riasatmorshed/name_338_project/Propeller/Propeller Calculation.docx

Propeller Calculation

Total resistance, R=112.6 kN

Effective power, PE = 112.6X10X.5144=579.24 kW

Ship Length, LBP=70.8 m= 232.28 ft

Breadth, B=11.42 m = 37.46 ft

Draft, T=4.4m = 14.44 ft

Speed, V=10 knots

Volume displacement, =2660m³=99652.04 ft³

Propeller diameter, D=.6T=2.6ft

Co-efficient ,DW= D/(√(∇^(1/3)).D) =0.429

LCB=0.34M=1.12ft

Taylor wake fraction,

ω t= 0.22

Dt = (DXB)/(∇^(2/3)) = 0.149

Thrust Deduction factot, t = 0.204

We know,

T(1-t) = R

T = 141.45 kN

ηH = ((1-t))/(1-ω_t) = 1.02

ηR = 1.04

VA = V(1-ωt )=7.8 knot=4.01 ms⁻¹

Shaft immersion, h= D/2+0.2 = 1.5 m

H= T(Draft)- h

= 2.9m

Thrust ,T =141.45 kN

P0 =Patm+ρgH

=129745 N/m²

PV = 1646N/m²

K=0.2(for single screw)

Z=3

D= 3.08m

Here, (A_E)/(A_0)=((1.3+0.3Z)T)/((P_0 -P_v )D^2)+K

= 0.5

We know, KT/j²= T/(ρ.D^2 V_a ^2)

= 1.3

From chart,

nm = .5

j=.4

and P/D=.79

here, j= (V_a)/(nD)

so, n = 3.85 rps = 231.34 rpm

assume, ηD = .7

PD= (P_E)/(η_D) = 579.24/.7 = 827.48 kw

Va = 7.7 knots

Bp = 1.158( (n×P_D ^.5)/(Va^2.5) )

= 45.35

δ = 3.28 (nD)/(Va)

= 252.93

And, P/D = .79

So , From Bp -δ chart we get,

ηo = .52

P/D=.67

Cavitation Check:

p_0 -p_v =99.6-10.05×shaft immersion

p_0 -p_v =99.6-10.05×1.5m

=83.85 kPa

q_(0.7R) =1/2×ρ×V_R ^2

= 1/2×1.000×(V_A ^2 +(0.7×π×n×D)^2

= 1/2×1.000×(4.01^2 +(0.7×π×3.85×2.6)^2

=250.33 kPa

σ_(0.7R) =(p_0 -p_v)/(q_(0.7R)) = 83.85/250.33 =0.33

(A_E)/(A_0)_(necessary) =T/(π/4×D^2 (1.067-0.229P/D)(0.3σ_(0.7R) ^0.5 -0.03)q_(0.7R))

= 141.45/(π/4×2.6^2 (1.067-0.229×0.67)(0.3×0.33^0.5 -0.03)250.33)

Therefore, A_E =0.818 m^2

Assuming A_E =A_D ,

A_E ≈(A_P)/(1.067-0.229×P/D)

A_P =3.97 m^2

τ_c =(T/(A_P))/(q_(0.7R)) =0.14

From Burrill Cavitation Diagram ( τ_c vs σ_(0.7R) ), the value obtained is just below the upper limit for merchant ship propeller.

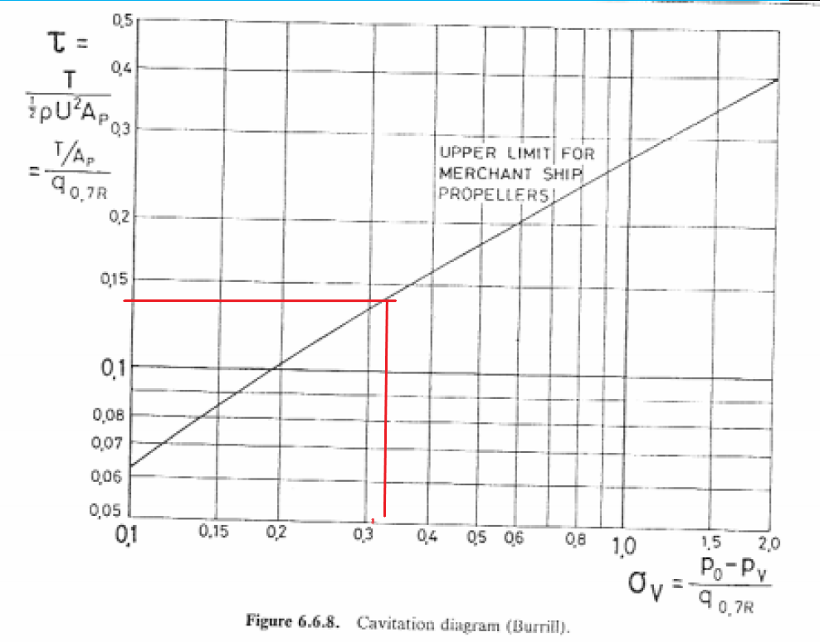
[picture p29: figure]

Here,

ηD Calculated = ηH x ηR x ηo

= 0.55

€ = ηDCalculated – ηD assumed

= 0.55 – 0.7 < 0.005

So, ηD = 0.55
