riasatmorshed/name_338_project/Rudder/Rudder Calculation.docx

Rudder Calculation:

LBP = 70.8 m

LWL = 73.75

T/L = .0621 m

T =4.4 m

L/B = 6.2

B = 11.4 m

Rudder Area:
A=c_1 ×c_2 ×c_3 ×c_4 ×(1.75×L_(WL) ×T)/100 A=1×1×1×1.5×(1.75×73.75×4.4)/100

=3.14 m^2

Yield Strength of mild steel = 235 N/m²

K_r =(235/250)^.75

Aspect ratio= (b^2)/a=b/c=(height)/(breadth)

⇒1.5= (b^2)/A

b^2 =4.71

b=2.17

Since b/T=2.17/2.5=.86 = 86% of the draft but the mean height should be as much as 60%-70% of the draft

Again, Aspect Ratio= 1.3

=(b^2)/A

⇒b^2 =1.3×3.14

⟹b=2.02

Now, b/T=2.02/2.5=.80 = 80% of the draft

Now, considering aspect ratio as 1.2,

(b^2)/A=1.2

b=1.94

c= 1.94/1.2=1.616

Rudder Force and Torque:

Rudder force, C_R =132×A^2 ×V^2 ×k_1 ×k_2 ×k_3 ×k_t

k1= (Aspect Ratio+2)/3=1.067

k2= 1.1(ahead condition)

k3= 0.8

kt=1
CR =132×3.14×12^2 ×1.067×1.1×.8×1

CR =56041.94 kN

Rudder Torque, QR=CR x r

Again, r= c×(α×K_b )

α= .33=for ahead condition

Now, K_b =(A_f)/A=.02

r = 1.616 x (.33 x .2)

= .11 m

QR= 56041.94 x .11

=6164.61 Nm

Rudder Stock:

Dt = 4.2 ×³√(Q_R ×K_R)

= 4.2 ×³√(28600×1)

= 128.4 mm

Couplings:

Db= .62×√((D^3 ×K_b)/(K_r ×n×e))

Kr= 0.95

n= total no of bolts

kb= metal factor for flanges

e= mean distance of of the bolt axis from the center of the bolt system

= 105/100×80

=84

Db= .62×√((80^3 ×1)/(.95×6×84))

= 20.27 mm

=21 mm

Thickness of the coupling flanges:

tr= 0.9 x db

= 0.9 x 21

= 18.9 mm

Thickness of coupling flange clear of the bolt hole,

Ts= (.65 x 21)mm

= 13.65 mm

Rudder Plating:

tp= 1.74 ×a×√(P_r ×k)+2.9

a= unsupported width

= 0.34 m

Design Pressure, Pr= 10T+ (C_R)/(10^3 ×A)

= 102.51+ 56.041/(10^3 ×3.44)

=25.11 kN/mm²

Thickness of rudder plating, tp= 1.74×.340×√(25.11×1)+2.5

= 5.46 mm

=6 mm

Thickness of the web is not to be less than, tw= .7 x 6mm= 4.2 mm

Rudder Bearings:

Tmin= 8 mm(since metallic material would be used)

Projected Surface, Ab= (B_i)/q

Bi= 56041.94 N = support reaction at carrier bearing

q= 7 N/mm²

Again, Abn= bearing height x external diameter of liner

External diameter of the liner= (Dt x tmin x 2)

= (80 + 18.9 x 2)

= 117. 8 mm

The diameter of the pintle, dp= 0.35 ×√(B_i ×K_r)

Bi= 56041.94= support reaction at the pintle

dp=80.75 mm

=81 m
