riasatmorshed/name_338_project/Scantling/Scantling Calculation.docx

Particulars:

Length: 70.8 m

Breadth: 11.4 m

Depth: 5.7 m

Draft: 4.4 m

Deadweight-Displacement Co-efficient: 0.7

Deadweight: 2000 tons

Displacement: 2660 tons

Material Factor, k: taking steel yield stress as 235MPa

k = 1

Web Frame Spacing: 1.8 m

Frame Spacing: 0.6 m = 600mm¹ Ship Construction by DJ Eyer

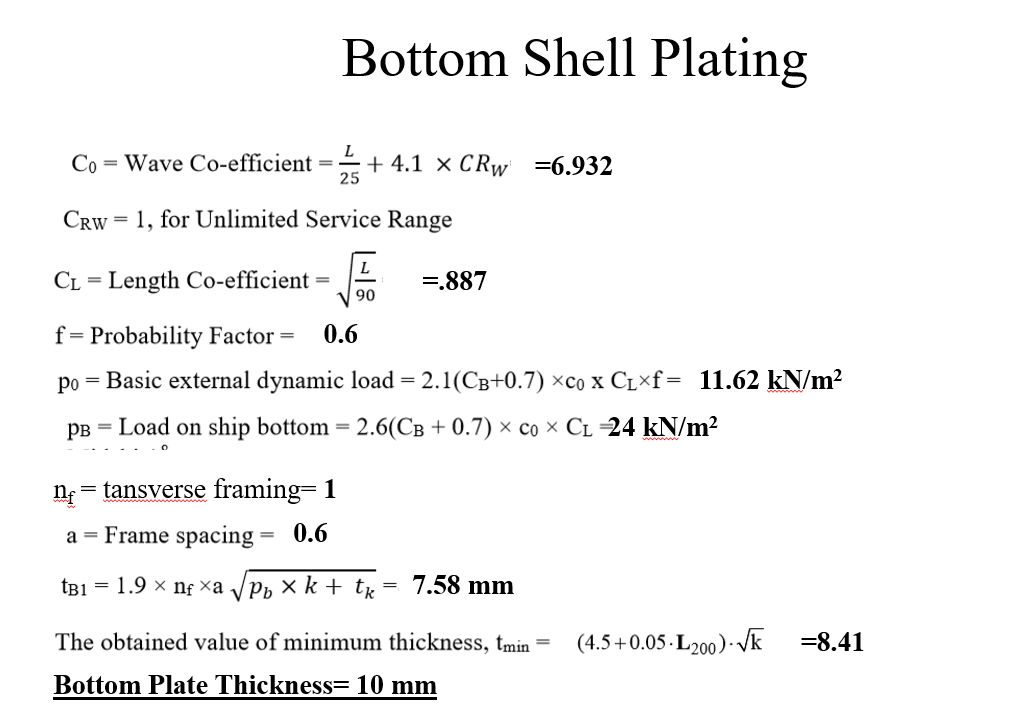
[picture p30: figure]
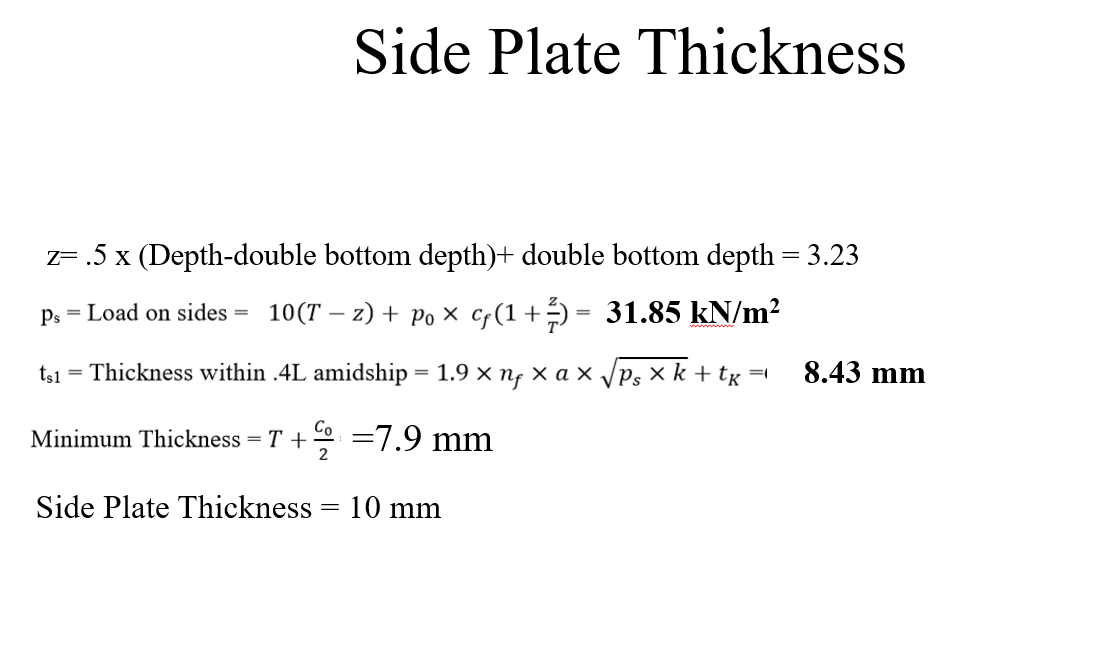
[picture p31: figure]
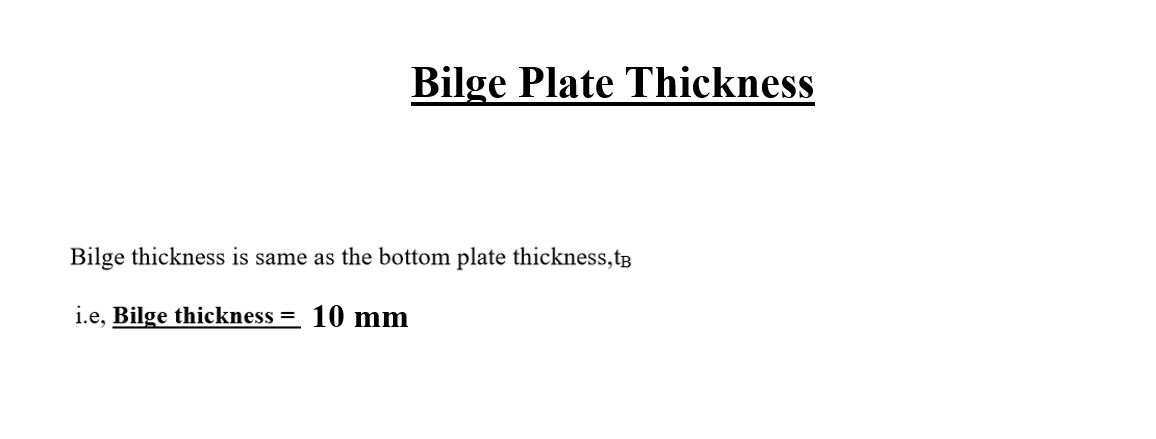
[picture p32: figure]
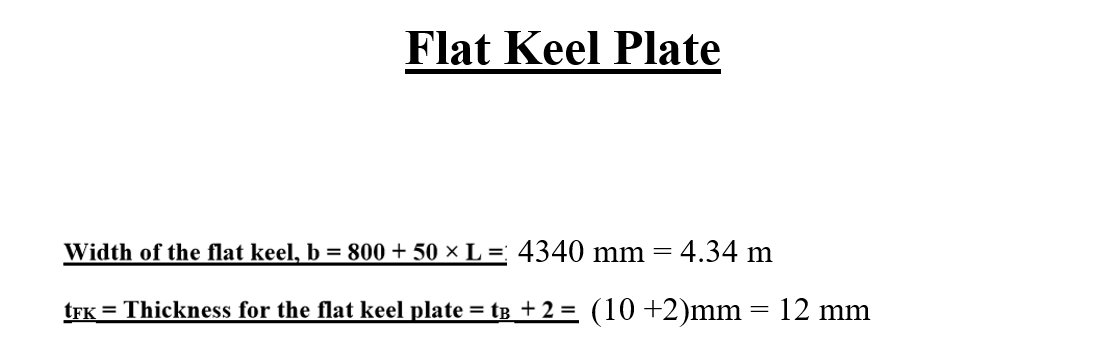
[picture p33: figure]
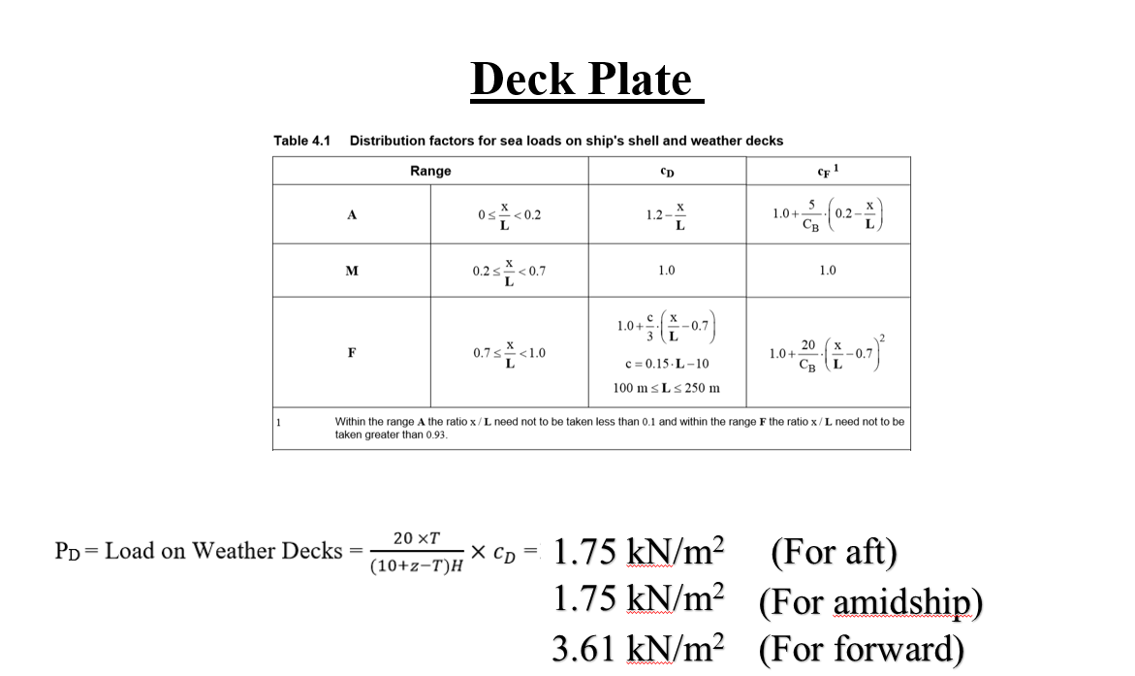
[picture p34: figure]
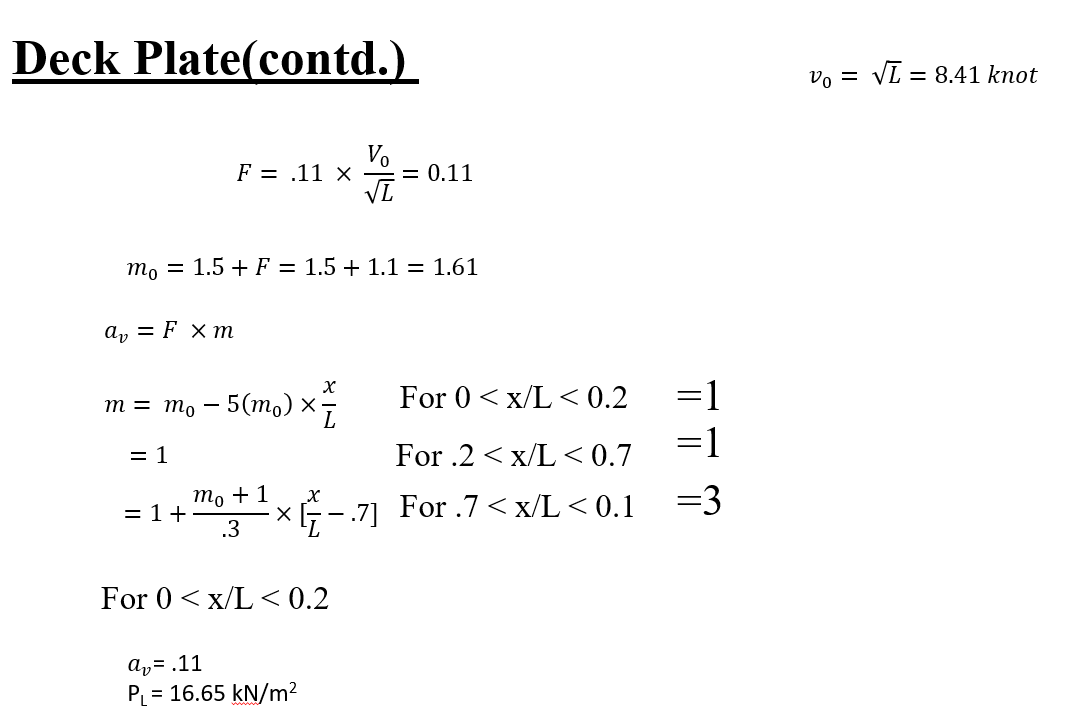
[picture p35: figure]
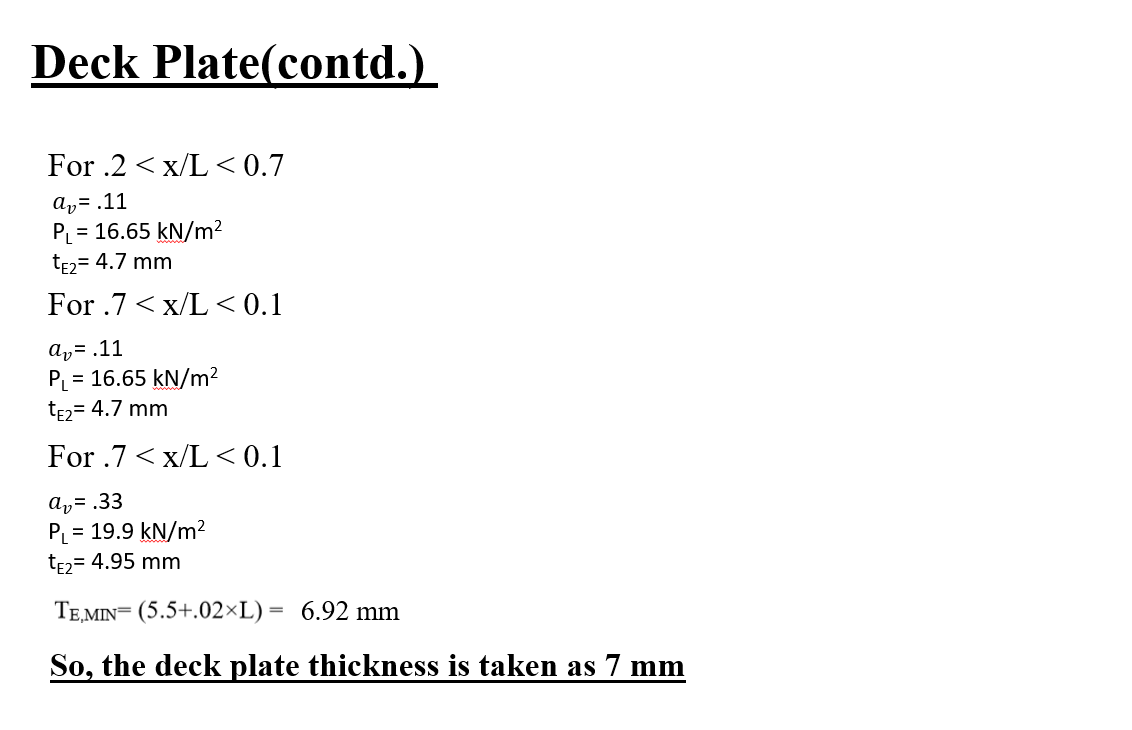
[picture p36: figure]
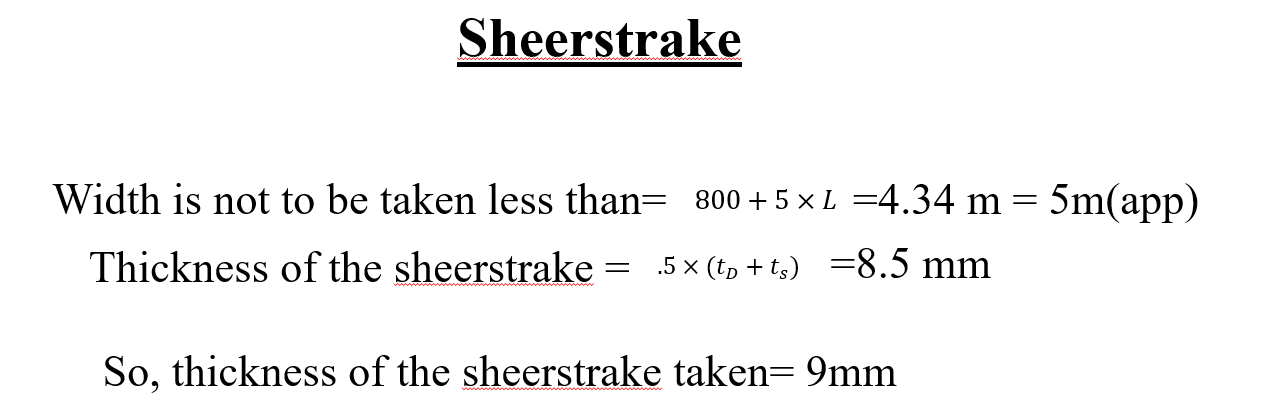
[picture p37: figure]
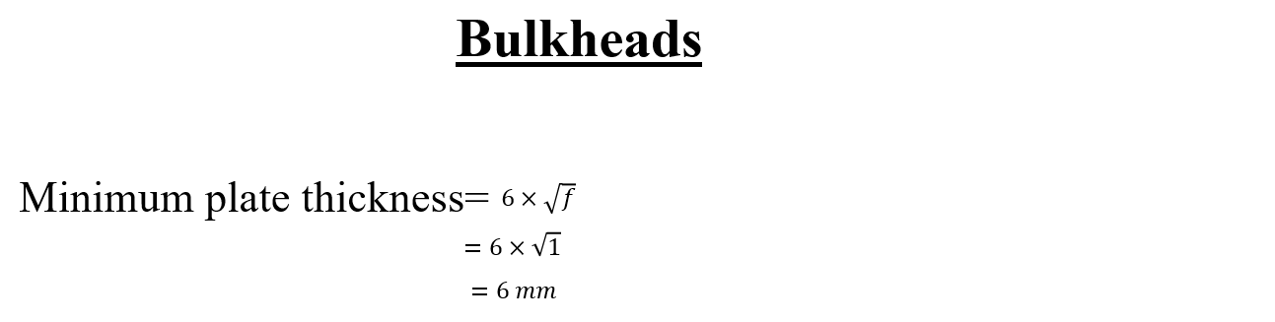
[picture p38: figure]
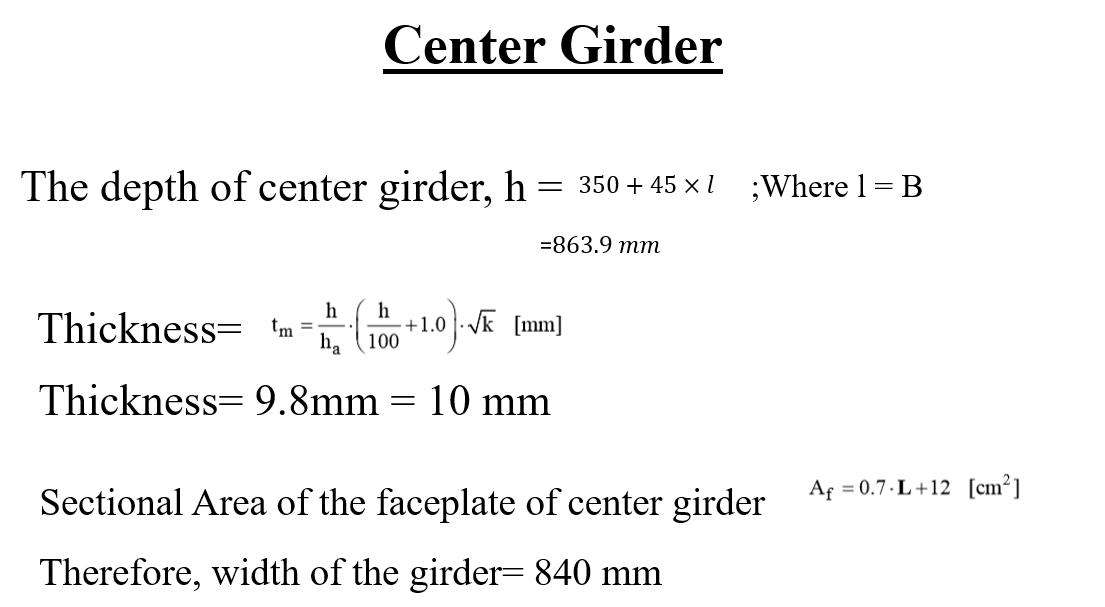
[picture p39: figure]
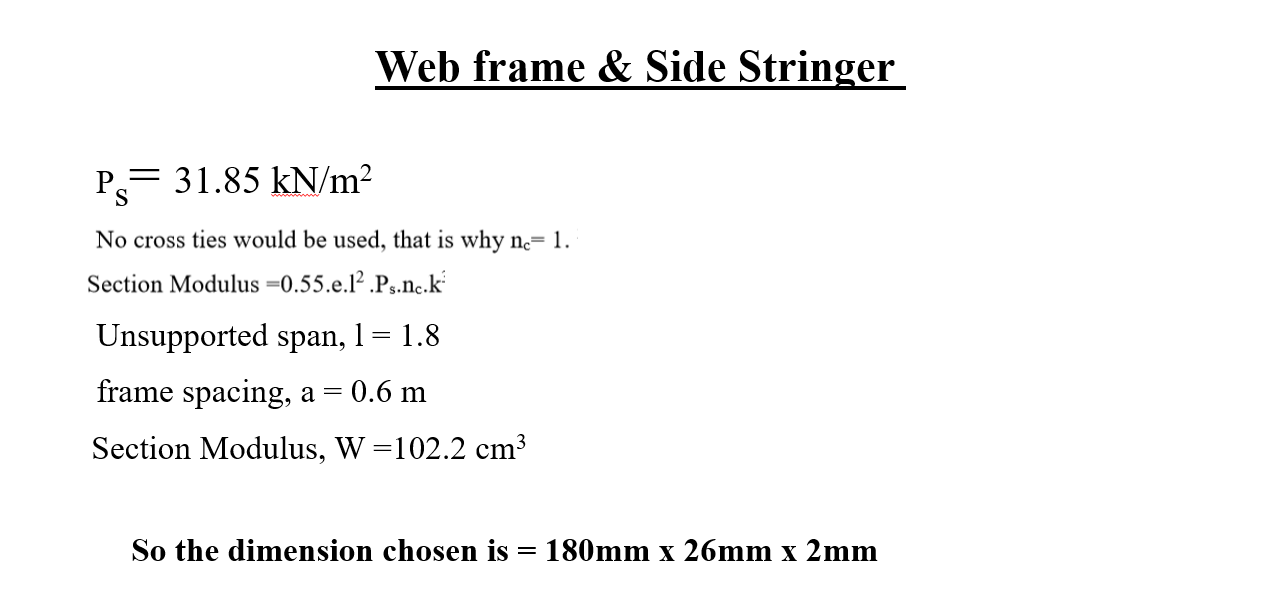
[picture p40: figure]
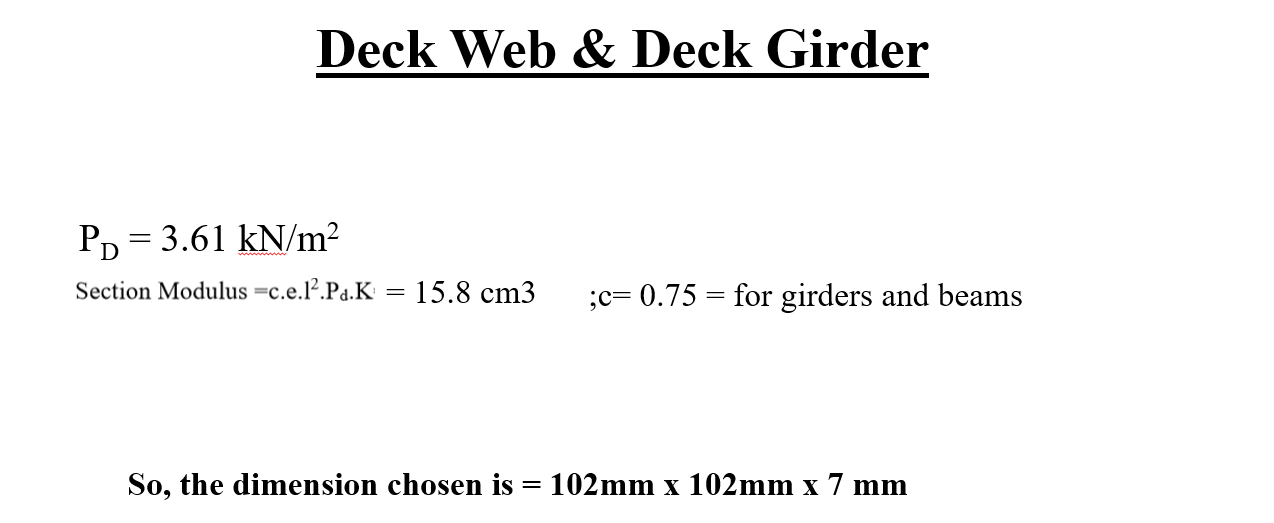
[picture p41: figure]
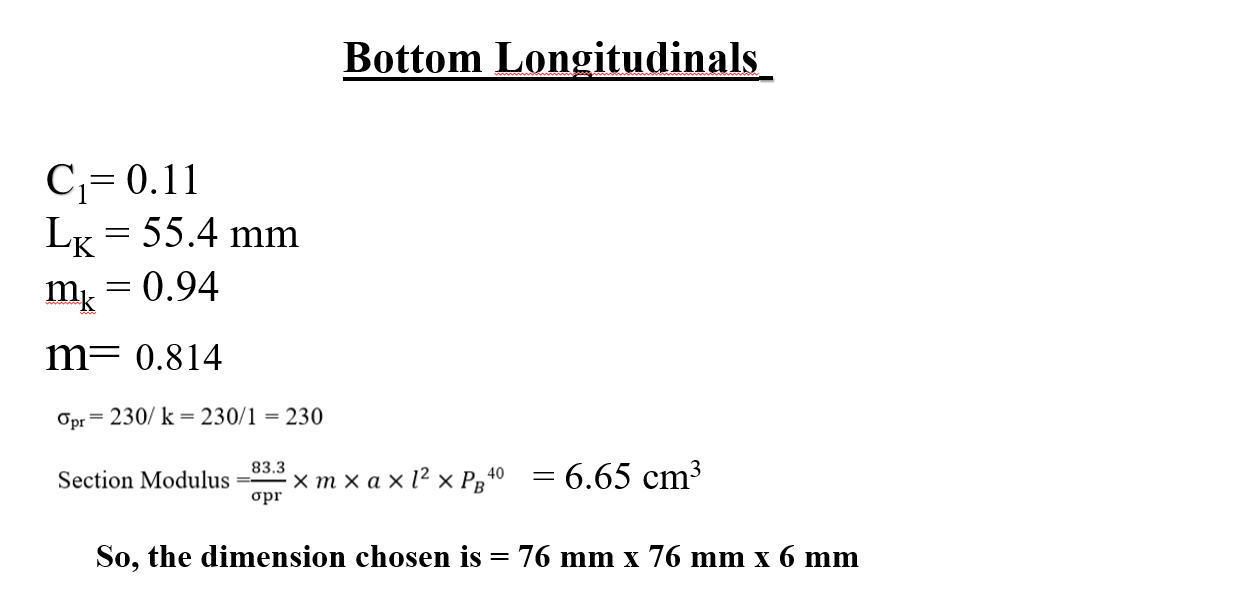
[picture p42: figure]
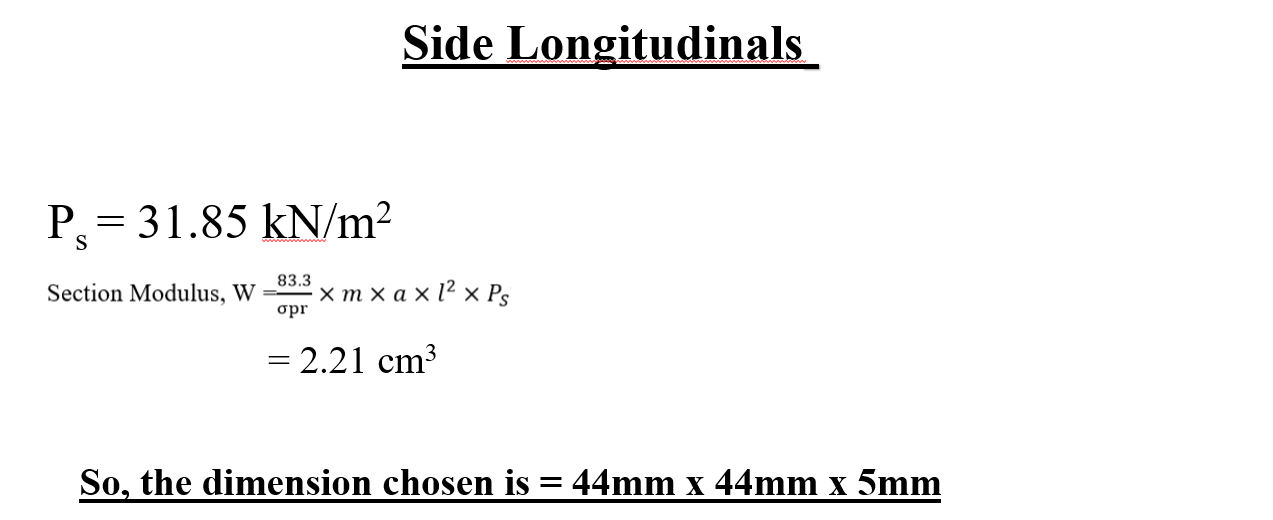
[picture p43: figure]
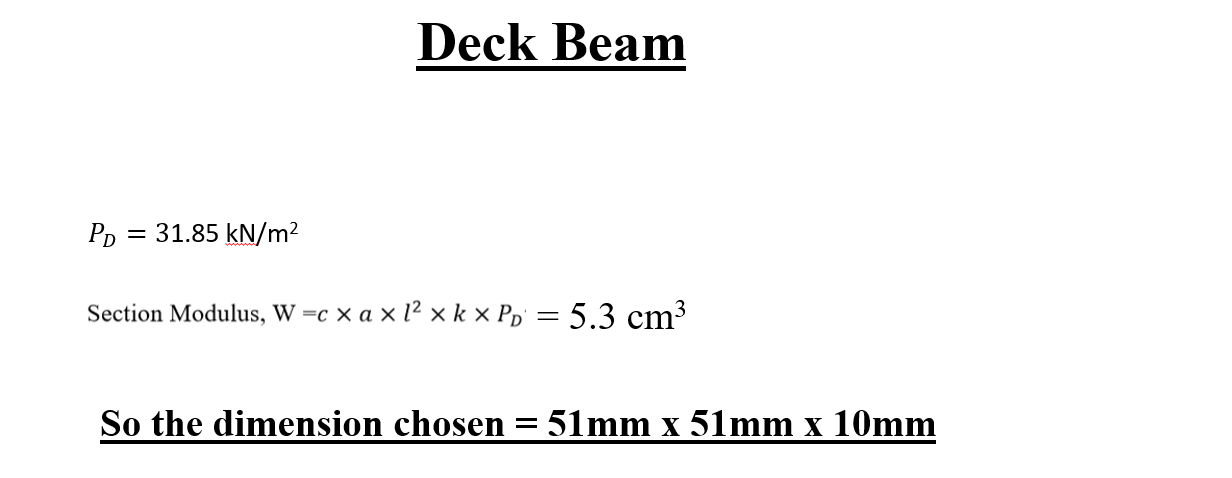
[picture p44: figure]
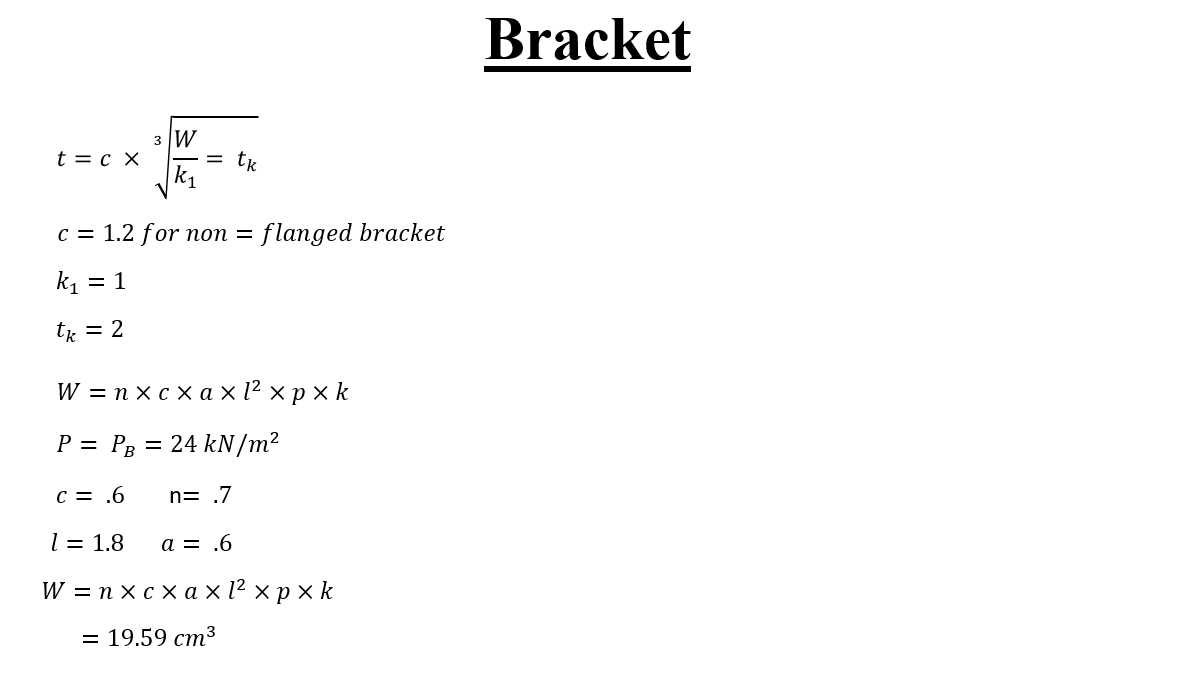
[picture p45: figure]
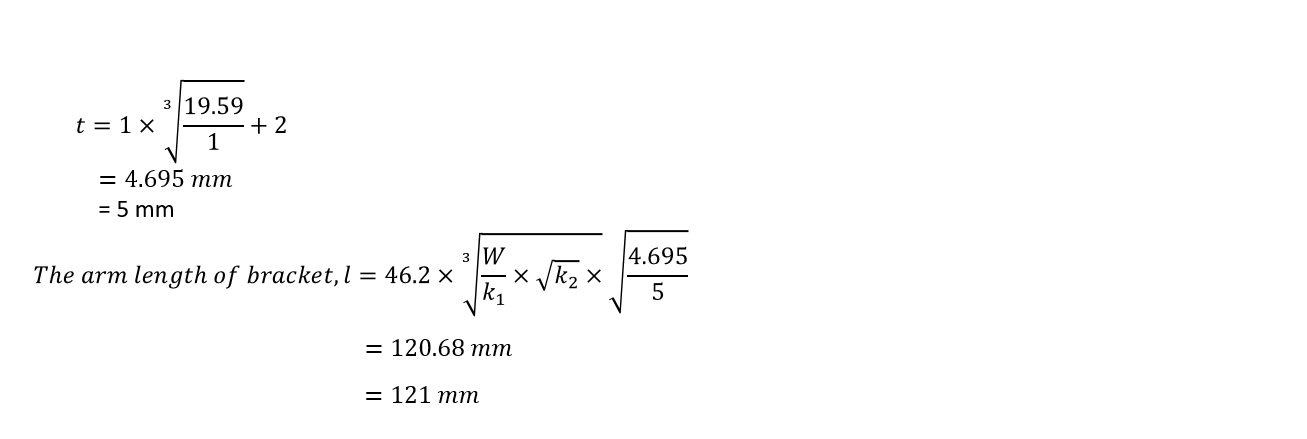
[picture p46: figure]
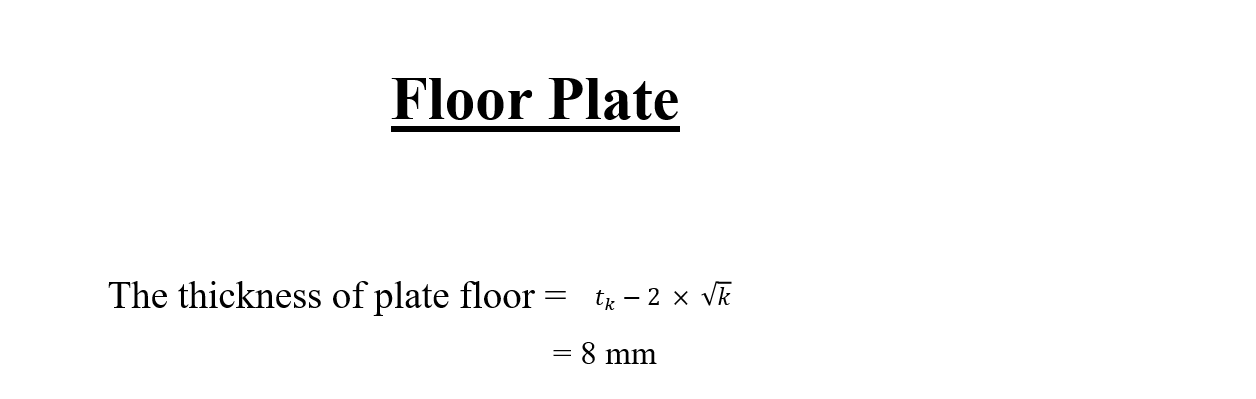
[picture p47: figure]
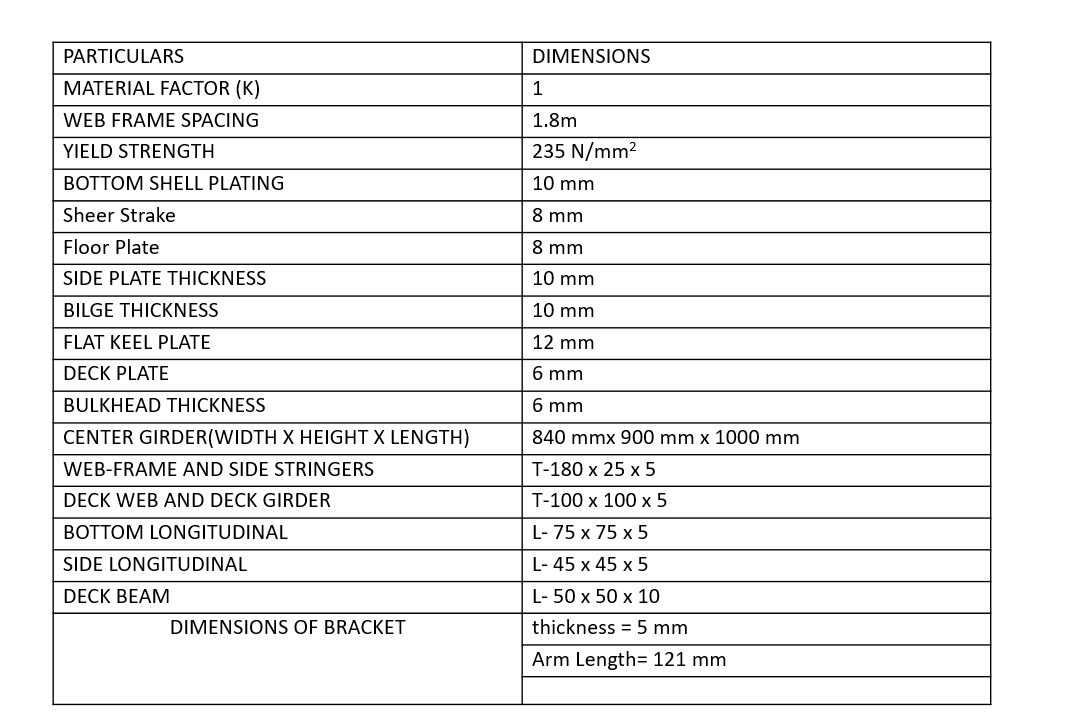
[picture p48: figure]
