riasatmorshed/name_338_project/Steering Gear/Steering Gear Arrangement Calculation.docx

Steering Gear

Principle Particulars:

LBP = 70.8 m

LWL = (1+.0167) x 70.8 = 72m

B = 11.4 m

T = 4.4 m

Particulars of Rudder:

b= height= 3.2

c= breadth =2.27

Rudder Area, A = 8.52 m²

Aspect Ratio = 1.2

Rudder Stock:

Dt = 4.2 x ³√(Q_R ×K_r)

= 4.2 x ³√(11615.912×1)

= 100 mm

Force and Torque Calculation:

Rudder Force, C_R =132 ×A^1 ×V^2 ×k_1 ×k_2 ×k_3 ×k_t

= v = v0 for ahead condition

k1= (Aspect ratio+2)/3 = 1.067

k2 = 1.1 (ahead condition)

k3= .8 (rudder outside the propeller jet)

kt= 1(normally)

CR = 132 x 8.52 x 10² x 1.067 x 1.1 x .8 x 1

= 105599.2 N

Rudder Torque, QR= CR x r

Again, r = c ( α ×K_b ) α=.33= for ahead condition

Kb = (A_f)/A = .2

r = 2.27x (.33 x 0.2)

= 0.15 m

QR = 105599.2 x .11

= 11615.912 Nm

This value is for ahead condition.

Now, for astern condition,

Taking 40% of 10 knot yields 4 knot which is below 5 knot. So as per instruction 6 knot is taken for calculating astern condition.

C_R =132 ×A^2 ×V^2 ×k_1 ×k_2 ×k_3 ×k_t

= 132 x 8.52 x 6² x 1.067 x 1.4 x .8 x 1

= 48383.63

Rudder Torque, QR= CR x r

Again, r = c (α × Kb)

α = .33 = for ahead condition

Kb = Af /A= 0.2

r = 2.27 x (.33 x 0.2)

= 0.15 m

QR = 105599.2 x .11

= 11615.912 Nm

Which is still greater than astern condition. Therefore, value for ahead condition is taken and previous calculation is taken as final result. And previous calculation is given below:

C_R =132 ×A^2 ×V^2 ×k_1 ×k_2 ×k_3 ×k_t

= v = v0 for astern condition

CR = 132 x 3.14 x 7² x 1.067 x 1.4 x .8 x 1

Here, other than k2 all the coefficients are as same as the ahead condition.

Therefore, CR= 24300 N

Rudder Torque, QR= CR x r

Again, r = c (α × Kb)

α = .33 = for ahead condition

Kb = Af /A= 0.2

r = 2.27 x (.33 x 0.2)

= 0.15 m

QR = 105599.2 x .11

= 11615.912 Nm

=12 kN

Steering Gear Arrangement Selection:

From 12 kN-m torque result we end up with Hydroster’s MS Series Piston type hydraulic steering gear arrangement .

And the design-model is “MS-25-35”

This particular model is capable of delivering 12 kN of working torque at working pressure wth α = 35°

And design torque is 25 kN with the angle, α = 35°
