riasatmorshed/name_338_project/Scantling/Scantling Calculation_pdf_format.pdf

Particulars:

Length: 70.8 m

Breadth: 11.4 m

Depth: 5.7 m

Draft: 4.4 m

Deadweight-Displacement Co-efficient: 0.7

Deadweight: 2000 tons

Displacement: 2660 tons

Material Factor, k: taking steel yield stress as 235MPa

k = 1

Web Frame Spacing: 1.8 m

Frame Spacing: 0.6 m = 600mm¹

Ship Construction by DJ Eyer


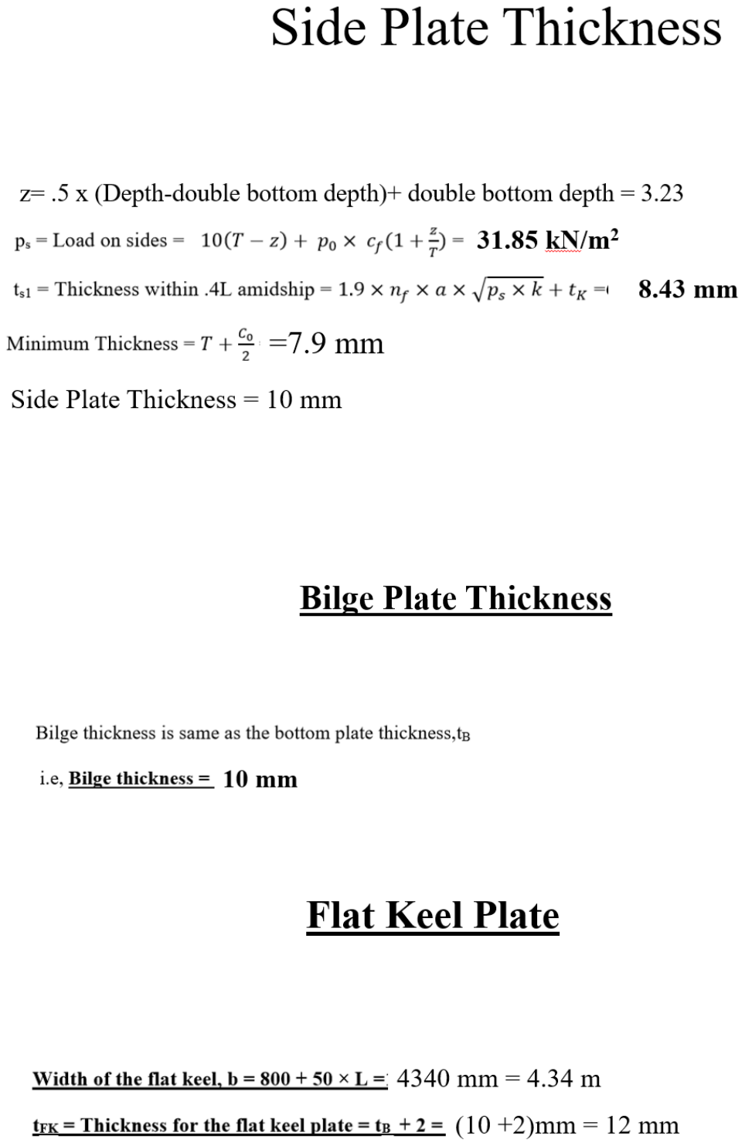
[picture p49: figure]

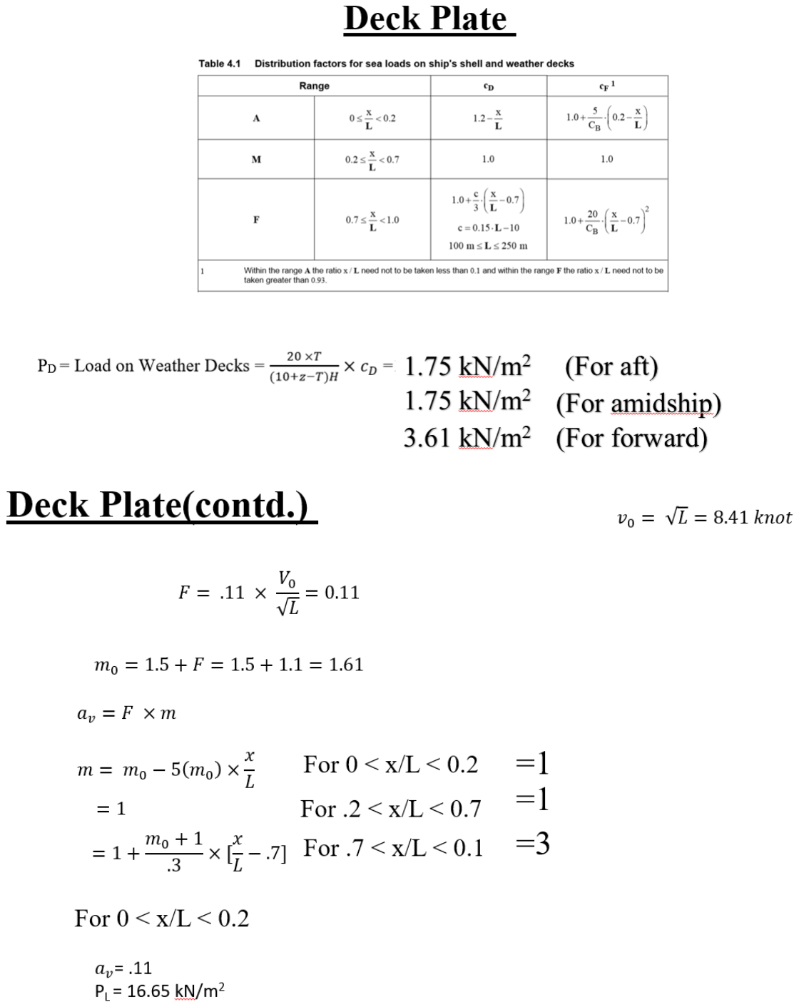
[picture p50: figure]
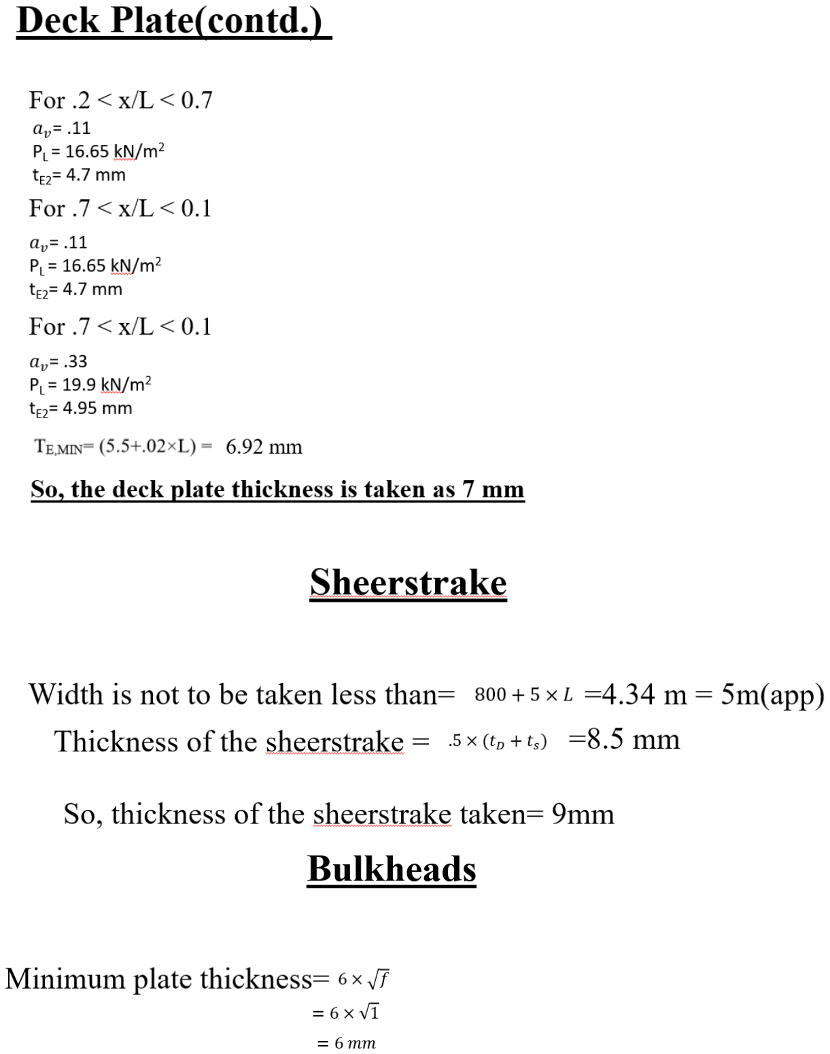
[picture p51: page 4]
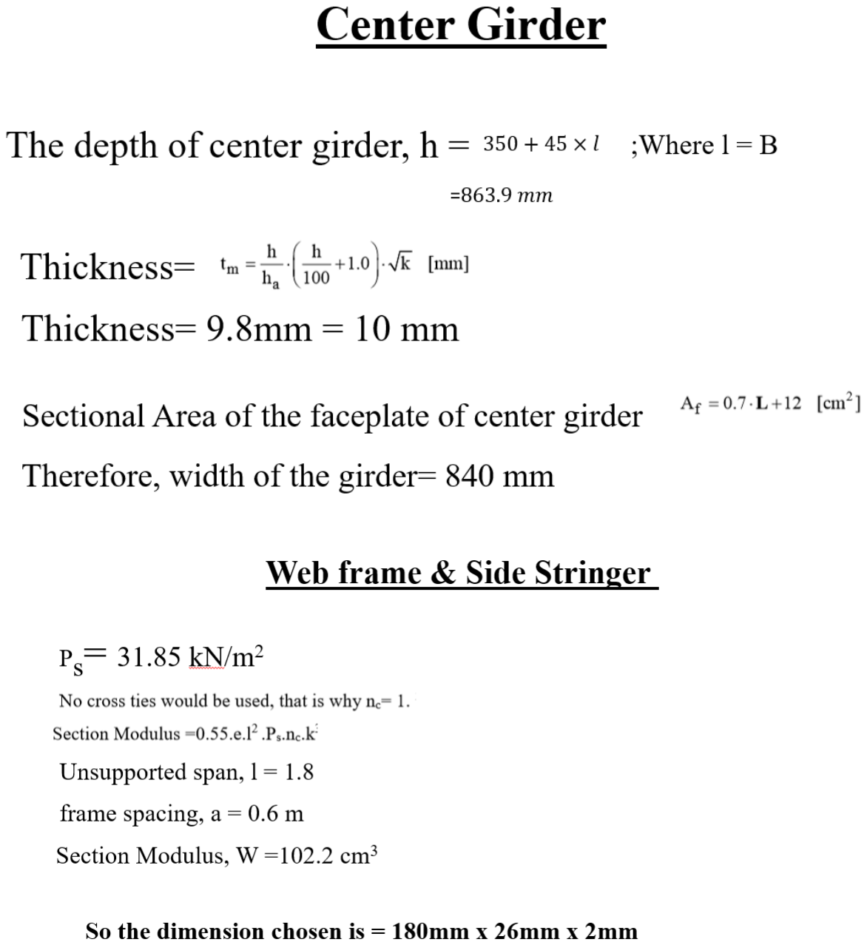
[picture p52: page 5]
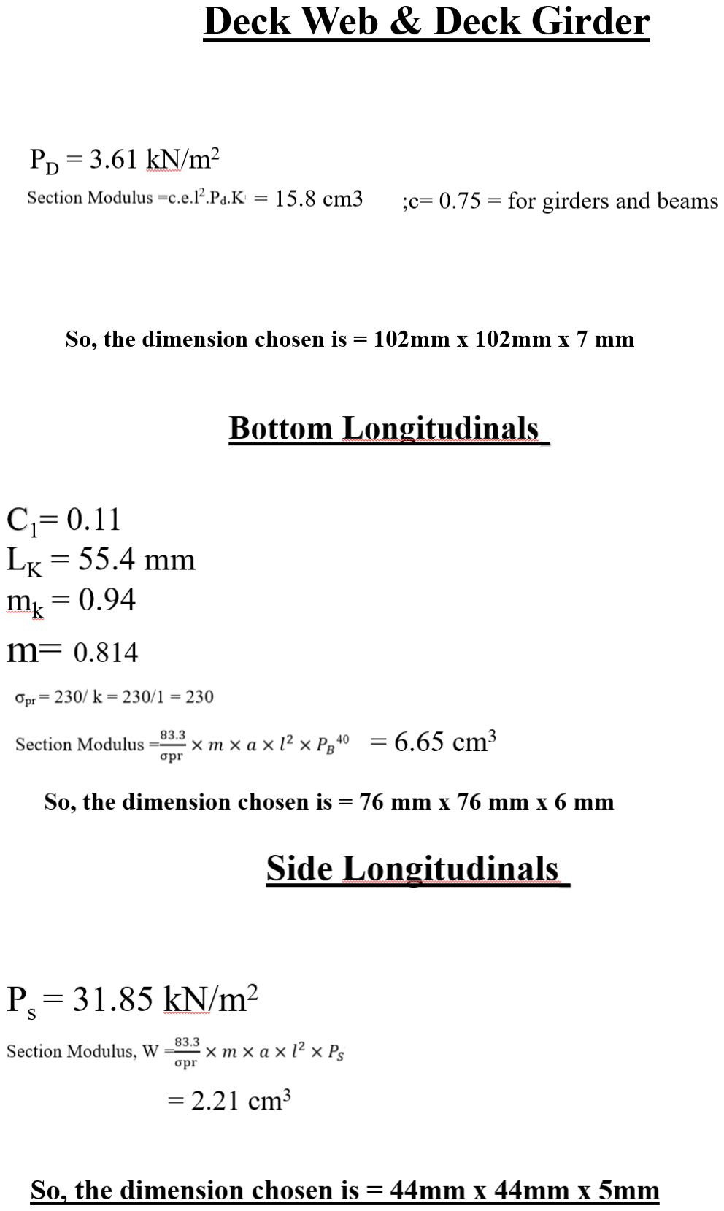
[picture p53: page 6]
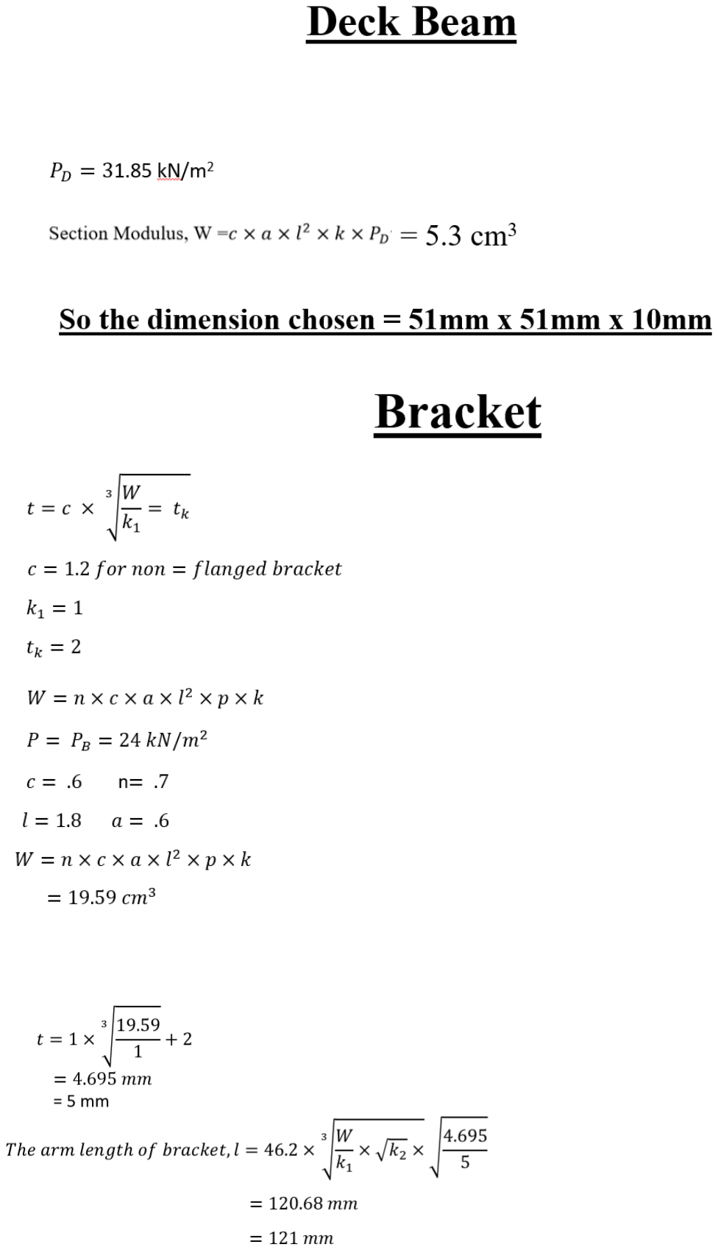
[picture p54: page 7]
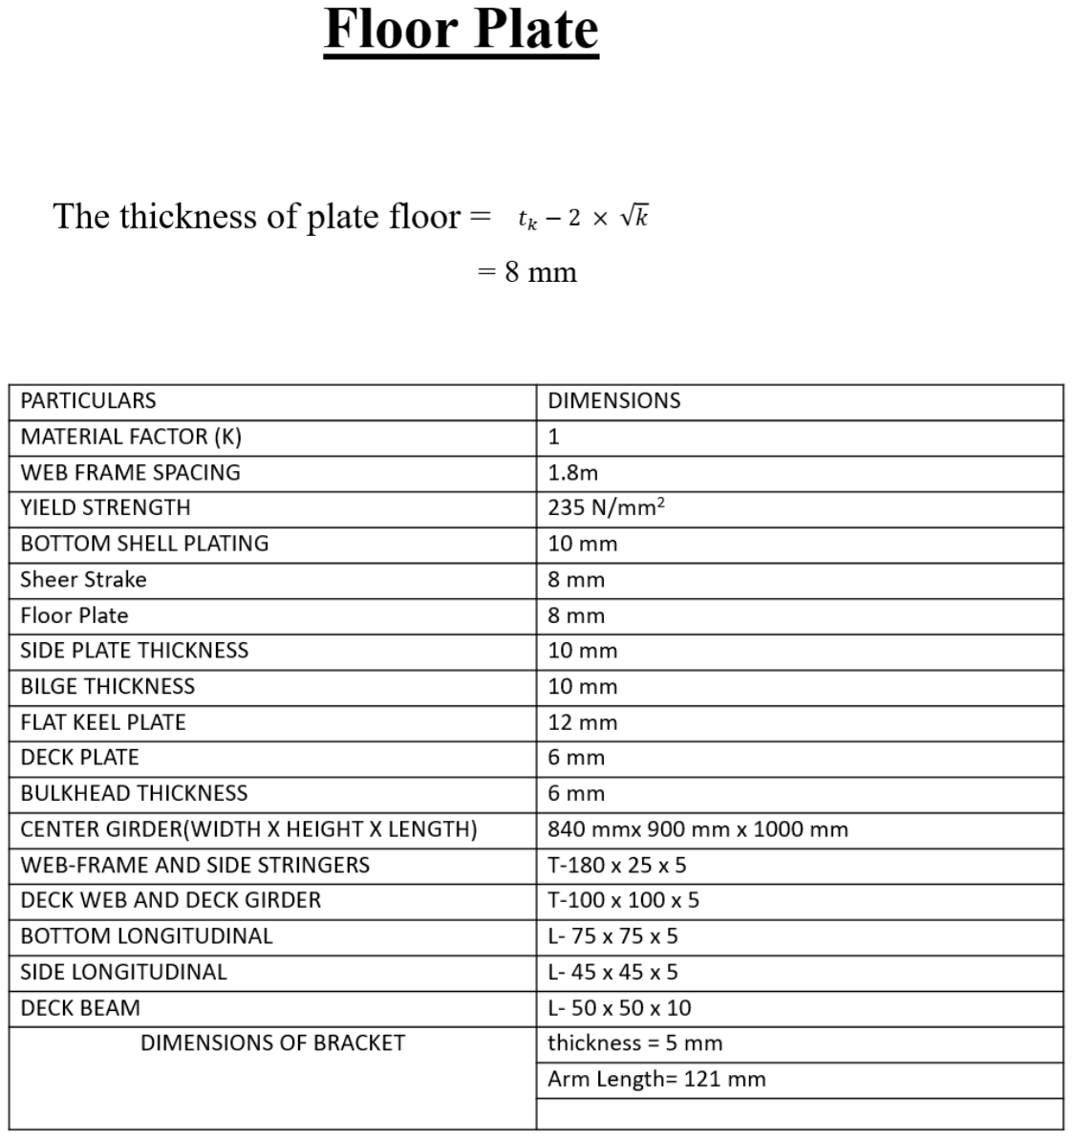
[picture p55: page 8]
