riasatmorshed/name_338_project/Weight Calculation/Weight_Calculation_Final.xlsx

Sheet: Combined LCG-VCG
 |  | Lightweight Calculation
 |  | Item | Weight (tonne) | LCG from Midship (m) | Moment for LCG (t-m) | VCG from keel (m) | Moment for VCG (t-m)
 |  | Center Girder | 8.43 | 0.24 | 2.0232 | 0.4 | 3.372
 |  | Side Girder |  |  | 0
 |  | 1 | 7.29 | 0.46 | 3.3534 | 0.68 | 4.9572
 |  | 2 | 7.29 | 0.46 | 3.3534 | 0.68 | 4.9572 | LCG= | 0.2485841364
 |  | 1 | 6.2 | 0 | 0 | 0.46 | 2.852 | VCG= | 0.5788880652
 |  | 2 | 6.2 | 0 | 0 | 0.46 | 2.852
 |  | sum | 26.98 | 0.92 | 6.7068 | 2.28 | 15.6184
 |  | Bottom Longitudinals
 |  | 1 | 0.33 | 1.46 | 0.4818 | 0.86 | 0.2838
 |  | 2 | 0.33 | 1.46 | 0.4818 | 0.86 | 0.2838
 |  | 1 | 0.33 | 1.46 | 0.4818 | 0.06 | 0.0198
 |  | 2 | 0.33 | 1.46 | 0.4818 | 0.06 | 0.0198
 |  | 1 | 0.31 | 1.15 | 0.3565 | 0.86 | 0.2666
 |  | 2 | 0.31 | 1.15 | 0.3565 | 0.86 | 0.2666
 |  | 1 | 0.31 | 1.15 | 0.3565 | 0.06 | 0.0186 | LCG= | 0.4991503268
 |  | 2 | 0.31 | 1.15 | 0.3565 | 0.06 | 0.0186 | VCG= | 0.4835294118
 |  | 1 | 0.29 | 0.8 | 0.232 | 0.86 | 0.2494
 |  | 2 | 0.29 | 0.8 | 0.232 | 0.86 | 0.2494
 |  | 1 | 0.29 | 0.8 | 0.232 | 0.06 | 0.0174
 |  | 2 | 0.29 | 0.8 | 0.232 | 0.06 | 0.0174
 |  | 1 | 0.27 | 0.5 | 0.135 | 0.86 | 0.2322
 |  | 2 | 0.27 | 0.5 | 0.135 | 0.86 | 0.2322
 |  | 1 | 0.27 | 0.5 | 0.135 | 0.06 | 0.0162
 |  | 2 | 0.27 | 0.5 | 0.135 | 0.06 | 0.0162
 |  | 1 | 0.24 | -0.64 | -0.1536 | 0.86 | 0.2064
 |  | 2 | 0.24 | -0.64 | -0.1536 | 0.86 | 0.2064
 |  | 1 | 0.24 | -0.64 | -0.1536 | 0.06 | 0.0144
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
Deck Beam | 16.30776 | Bottom Plate | 13.75 | 0.13 | 1.7875 | 0.005 | 0.06875
 |  | Bilge Plate | 13.79 | 1.5 | 20.685 | 0.75 | 10.3425
 |  | Shell Plate | 15.64 | -0.53 | -8.2892 | 2.85 | 44.574
 |  | Shear Strake | 6.15 | 1.25 | 7.6875 | 5.5 | 33.825
 |  |  | 298.94

Sheet: SteelWeightDetail Calculation
Longitudinal Member
Center Girder
Dimension | Width | Height | Area | Length | Dist from keel | Moment about keel | Volume | Density(ton/m^3) | Weight(tons)
Web | 0.01 | 0.89 | 0.0089 | 62.5 | 0.895 | 0.0079655 | 0.55625 | 7.8 | 4.33875
Flange | 0.84 | 0.01 | 0.0084 | 62.5 | 0.005 | 4.2e-05 | 0.525 | 7.8 | 4.095
 |  |  | 0.0173 |  | VCG= | 0.4628612717 |  |  | 8.43375
 |  |  |  |  | LCG= | 2.24 | fore(positive)
Side Girder
Girder 1 (x2)
Dimension | Width | Height | Area | Length | Dist from keel | Moment about keel | Volume | Density(ton/m^3) | Weight(tons)
Web | 0.01 | 0.89 | 0.0089 | 54 | 0.895 | 0.0079655 | 0.4806 | 7.8 | 3.74868
Flange | 0.84 | 0.01 | 0.0084 | 54 | 0.445 | 0.003738 | 0.4536 | 7.8 | 3.53808
 |  |  |  |  | VCG= | 0.6765028902 |  |  | 7.28676
 |  |  |  |  | LCG= | 0.467 | fore(positive) |  | 7.28676
Girder2 (x2)
Dimension | Width | Height | Area | Length | Dist from keel | Moment about keel | Volume | Density(ton/m^3) | Weight(tons)
Web | 0.01 | 0.89 | 0.0089 | 46 | 0.895 | 0.0079655 | 0.4094 | 7.8 | 3.19332
Flange | 0.84 | 0.01 | 0.0084 | 46 | 0.005 | 4.2e-05 | 0.3864 | 7.8 | 3.01392
 |  |  |  |  | VCG= | 0.4628612717 |  |  | 6.20724
 |  |  |  |  | LCG= | 0
Bottom Longitudinals
Logitudinals 1(floor x2)
Dimension | Width | Height | Area | Length | Dist from keel | Moment about keel | Volume | Density(ton/m^3) | Weight(tons)
Web | 0.07 | 0.005 | 0.00035 | 59 | 0.88 | 0.000308 | 0.02065 | 7.8 | 0.16107
Flange | 0.075 | 0.005 | 0.000375 | 59 | 0.84 | 0.000315 | 0.022125 | 7.8 | 0.172575
 |  |  |  |  | VCG= | 0.8593103448 |  |  | 0.333645
 |  |  |  |  | LCG= | 1.46 | fore(positive)
Logitudinals 1(keel x2)
Dimension | Width | Height | Area | Length | Dist from keel | Moment about keel | Volume | Density(ton/m^3) | Weight(tons)
Web | 0.07 | 0.005 | 0.00035 | 59 | 0.047 | 1.645e-05 | 0.02065 | 7.8 | 0.16107
Flange | 0.075 | 0.005 | 0.000375 | 59 | 0.085 | 3.1875e-05 | 0.022125 | 7.8 | 0.172575
 |  |  |  |  | VCG= | 0.06665517241 |  |  | 0.333645
 |  |  |  |  | LCG= | 1.46 | fore(positive)
Logitudinals 2(floor x2)
Dimension | Width | Height | Area | Length | Dist from keel | Moment about keel | Volume | Density(ton/m^3) | Weight(tons)
Web | 0.07 | 0.005 | 0.00035 | 56.2 | 0.88 | 0.000308 | 0.01967 | 7.8 | 0.153426
Flange | 0.075 | 0.005 | 0.000375 | 56.2 | 0.84 | 0.000315 | 0.021075 | 7.8 | 0.164385
 |  |  |  |  | VCG= | 0.8593103448 |  |  | 0.317811
 |  |  |  |  | LCG= | 1.15 | fore(positive)
Logitudinals 2(keel x2)
Dimension | Width | Height | Area | Length | Dist from keel | Moment about keel | Volume | Density(ton/m^3) | Weight(tons)
Web | 0.07 | 0.005 | 0.00035 | 56.2 | 0.047 | 1.645e-05 | 0.01967 | 7.8 | 0.153426
Flange | 0.075 | 0.005 | 0.000375 | 56.2 | 0.085 | 3.1875e-05 | 0.021075 | 7.8 | 0.164385
 |  |  |  |  | VCG= | 0.06665517241 |  |  | 0.317811
 |  |  |  |  | LCG= | 1.15 | fore(positive)
Logitudinals 3(floor x2)
Dimension | Width | Height | Area | Length | Dist from keel | Moment about keel | Volume | Density(ton/m^3) | Weight(tons)
Web | 0.07 | 0.005 | 0.00035 | 51.7 | 0.88 | 1.645e-05 | 0.018095 | 7.8 | 0.141141
Flange | 0.075 | 0.005 | 0.000375 | 51.7 | 0.84 | 3.1875e-05 | 0.0193875 | 7.8 | 0.1512225
 |  |  |  |  | VCG= | 0.8593103448 |  |  | 0.2923635
 |  |  |  |  | LCG= | 0.8 | fore(positive)
Logitudinals 3(keel x2)
Dimension | Width | Height | Area | Length | Dist from keel | Moment about keel | Volume | Density(ton/m^3) | Weight(tons)
Web | 0.07 | 0.005 | 0.00035 | 51.7 | 0.047 | 1.645e-05 | 0.018095 | 7.8 | 0.141141
Flange | 0.075 | 0.005 | 0.000375 | 51.7 | 0.085 | 3.1875e-05 | 0.0193875 | 7.8 | 0.1512225
 |  |  |  |  | VCG= | 0.06665517241 |  |  | 0.2923635
 |  |  |  |  | LCG= | 0.8 | fore(positive)
Logitudinals 4(floor x2)
Dimension | Width | Height | Area | Length | Dist from keel | Moment about keel | Volume | Density(ton/m^3) | Weight(tons)
Web | 0.07 | 0.005 | 0.00035 | 49.2 | 0.88 | 1.645e-05 | 0.01722 | 7.8 | 0.134316
Flange | 0.075 | 0.005 | 0.000375 | 49.2 | 0.84 | 3.1875e-05 | 0.01845 | 7.8 | 0.14391
 |  |  |  |  | VCG= | 0.8593103448 |  |  | 0.278226
 |  |  |  |  | LCG= | 0.5
Logitudinals 4(keel x2)
Dimension | Width | Height | Area | Length | Dist from keel | Moment about keel | Volume | Density(ton/m^3) | Weight(tons)
Web | 0.07 | 0.005 | 0.00035 | 49.2 | 0.047 | 1.645e-05 | 0.01722 | 7.8 | 0.134316
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
 |  |  |  |  | VCG= | 6.1115 |  |  | 1.327365
 |  |  |  |  | LCG= | 1.3 | fore(positive)
Deck Longitudinals(4) x2
Dimension | Width | Height | Area | Length | Dist from keel | Moment about keel | Volume | Density(ton/m^3) | Weight(tons)
Web | 0.05 | 0.045 | 0.00225 | 65.78 | 6.03 | 0.0135675 | 0.148005 | 7.8 | 1.154439
Flange | 0.05 | 0.005 | 0.00025 | 65.78 | 6 | 0.0015 | 0.016445 | 7.8 | 0.128271
 |  |  |  |  | VCG= | 6.027 |  |  | 1.28271
 |  |  |  |  | LCG= | 0.95 | fore(positive)
Deck Longitudinals(5) x2
Dimension | Width | Height | Area | Length | Dist from keel | Moment about keel | Volume | Density(ton/m^3) | Weight(tons)
Web | 0.05 | 0.045 | 0.00225 | 58.88 | 5.87 | 0.0132075 | 0.13248 | 7.8 | 1.033344
Flange | 0.05 | 0.005 | 0.00025 | 58.88 | 5.85 | 0.0014625 | 0.01472 | 7.8 | 0.114816
 |  |  |  |  | VCG= | 5.868 |  |  | 1.14816
 |  |  |  |  | LCG= | 0.24 | fore(positive)
Deck Longitudinals(6) x2
Dimension | Width | Height | Area | Length | Dist from keel | Moment about keel | Volume | Density(ton/m^3) | Weight(tons)
Web | 0.05 | 0.045 | 0.00225 | 56.3 | 5.8 | 0.01305 | 0.126675 | 7.8 | 0.988065
Flange | 0.05 | 0.005 | 0.00025 | 56.3 | 5.77 | 0.0014425 | 0.014075 | 7.8 | 0.109785
 |  |  |  |  | VCG= | 5.797 |  |  | 1.09785
 |  |  |  |  | LCG= | -1.06 | aft(negative)
Side Stringer(1) x2
Dimension | Width | Height | Area | Length | Dist from keel | Moment about keel | Volume | Density(ton/m^3) | Weight(tons)
Web | 0.05 | 0.175 | 0.00875 | 68.66 | 1.81 | 0.0158375 | 0.600775 | 7.8 | 4.686045
Flange | 0.25 | 0.005 | 0.00125 | 68.66 | 1.81 | 0.0022625 | 0.085825 | 7.8 | 0.669435
 |  |  |  |  | VCG= | 1.81 |  |  | 5.35548
 |  |  |  |  | LCG= | -0.35 | aft(negative)
Side Stringer (2) x2
Dimension | Width | Height | Area | Length | Dist from keel | Moment about keel | Volume | Density(ton/m^3) | Weight(tons)
Web | 0.05 | 0.175 | 0.00875 | 71.17 | 3.61 | 0.0315875 | 0.6227375 | 7.8 | 4.8573525
Flange | 0.25 | 0.005 | 0.00125 | 71.17 | 3.61 | 0.0045125 | 0.0889625 | 7.8 | 0.6939075
 |  |  |  |  | VCG= | 3.61 |  |  | 5.55126
 |  |  |  |  | LCG= | -0.383 | aft(negative)
Side Stringer (3) x2
Dimension | Width | Height | Area | Length | Dist from keel | Moment about keel | Volume | Density(ton/m^3) | Weight(tons)
Web | 0.05 | 0.175 | 0.00875 | 73 | 5.41 | 0.0473375 | 0.63875 | 7.8 | 4.98225
Flange | 0.25 | 0.005 | 0.00125 | 73 | 5.41 | 0.0067625 | 0.09125 | 7.8 | 0.71175
 |  |  |  |  | VCG= | 5.41 |  |  | 5.694
 |  |  |  |  | LCG= | 0
Side Longitudinals(1) x2
Dimension | Width | Height | Area | Length | Dist from keel | Moment about keel | Volume | Density(ton/m^3) | Weight(tons)
Web | 0.05 | 0.04 | 0.002 | 69.64 | 2.4 | 0.0048 | 0.13928 | 7.8 | 1.086384
Flange | 0.45 | 0.005 | 0.00225 | 69.64 | 2.31 | 0.0051975 | 0.15669 | 7.8 | 1.222182
 |  |  |  |  | VCG= | 2.352352941 |  |  | 2.308566
 |  |  |  |  | LCG= | -0.46 | aft(negative)
Side Longitudinals(2) x2
Dimension | Width | Height | Area | Length | Dist from keel | Moment about keel | Volume | Density(ton/m^3) | Weight(tons)
Web | 0.05 | 0.04 | 0.002 | 70.46 | 3 | 0.006 | 0.14092 | 7.8 | 1.099176
Flange | 0.45 | 0.005 | 0.00225 | 70.46 | 2.98 | 0.006705 | 0.158535 | 7.8 | 1.236573
 |  |  |  |  | VCG= | 2.989411765 |  |  | 2.335749
 |  |  |  |  | LCG= | -0.46 | aft(negative)
Side Longitudinals(3) x2
Dimension | Width | Height | Area | Length | Dist from keel | Moment about keel | Volume | Density(ton/m^3) | Weight(tons)
Web | 0.05 | 0.04 | 0.002 | 71.8 | 4.28 | 0.00856 | 0.1436 | 7.8 | 1.12008
Flange | 0.45 | 0.005 | 0.00225 | 71.8 | 4.19 | 0.0094275 | 0.16155 | 7.8 | 1.26009
 |  |  |  |  | VCG= | 4.232352941 |  |  | 2.38017
 |  |  |  |  | LCG= | -0.27 | aft(negative)
Side Longitudinals(4) x2
Dimension | Width | Height | Area | Length | Dist from keel | Moment about keel | Volume | Density(ton/m^3) | Weight(tons)
Web | 0.05 | 0.04 | 0.002 | 72.4 | 4.8 | 0.0096 | 0.1448 | 7.8 | 1.12944
Flange | 0.45 | 0.005 | 0.00225 | 72.4 | 4.79 | 0.0107775 | 0.1629 | 7.8 | 1.27062
 |  |  |  |  | VCG= | 4.794705882 |  |  | 2.40006
 |  |  |  |  | LCG= | -0.14 | aft(negative)
Keel Plate
Plate Name | Length | Width | Thickness | Volume | Density | Weight | Distance from Midship | Moment about midship | VCG
K1 | 4.5 | 0.95 | 0.012 | 0.0513 | 7.8 | 0.40014 | -24.14 | -9.6593796 | 0.006
K2 | 6 | 0.95 | 0.012 | 0.0684 | 7.8 | 0.53352 | -19.53 | -10.4196456 | 0.006
K3 | 6 | 0.95 | 0.012 | 0.0684 | 7.8 | 0.53352 | -13.53 | -7.2185256 | 0.006
K4 | 6 | 0.95 | 0.012 | 0.0684 | 7.8 | 0.53352 | -7.7 | -4.108104 | 0.006
K5 | 6 | 0.95 | 0.012 | 0.0684 | 7.8 | 0.53352 | -1.2 | -0.640224 | 0.006 | LCG= | 2.334871795
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
Name | area | thickness | volume | Density | weight | lcg | vcg | moment abt lcg | moment abt vcg
BHD 1 | 230 | 0.006 | 1.38 | 7.8 | 10.764 | 4.5 | 2.724 | 48.438 | 29.321136
Deck Beam
Name | area | thickness | volume | Density | weight | lcg | vcg | moment abt lcg | moment abt vcg

Sheet: Summary
Steelweight Summary
Item | Weight (tonne) | LCG from Midship (m) | Moment for LCG (t-m) | VCG from keel (m) | Moment for VCG (t-m)
Center Girder | 8.43 | 0.24 | 2.02 | 0.40 | 3.37
Side Girder | 53.96 | 0.25 | 13.41 | 0.58 | 31.24
Bottom Longitudinals | 24.48 | 0.50 | 12.22 | 0.48 | 11.84
Deck Center Girder | 3.10 | 2.10 | 6.51 | 6.34 | 19.65
Deck Girder | 15.00 | 0.62 | 9.25 | 5.92 | 88.84
Deck Longitudinals | 16.00 | 0.98 | 15.74 | 6.08 | 97.21 |  | LCG= | -0.83
Side Stringer | 33.20 | -0.24 | -7.99 | 2.85 | 94.62 |  | VCG= | 2.79
Side Longitudinals | 19.00 | -0.33 | -6.27 | 2.87 | 54.53
Keel Plate | 10.40 | 2.33 | 24.23 | 0.01 | 0.06
Bottom Plate | 30.20 | 0.13 | 3.93 | 0.01 | 0.15
Bilge Plate | 30.40 | 1.50 | 45.60 | 0.75 | 22.80
Shell Plate | 34.40 | -0.53 | -18.23 | 2.85 | 98.04
Shear Strake | 14.00 | 1.25 | 17.50 | 5.50 | 77.00
Web Frame | 24.00 | -0.30 | -7.12 | 2.94 | 70.47
Ordinary Frame | 12.20 | 0.82 | 10.01 | 2.93 | 35.80
Transverse Bulkhead | 17.40 | 1.57 | 27.33 | 2.72 | 47.40
Centerline Bulkhead | 10.80 | 4.50 | 48.60 | 2.72 | 29.42
Bracket | 5.00 | -1.50 | -7.50 | 3.50 | 17.50
Floor Plate | 41.00 | 0.59 | 24.12 | 0.92 | 37.56
Deck Beam | 16.30 | 1.20 | 19.56 | 5.70 | 92.91
Bulkhead Longitudinals | 12.00 | 4.50 | 54.00 | 3.36 | 40.32
Superstructure Plate | 26.25 | -17.40 | -456.75 | 10.20 | 267.75
Side Stringer | 8.01 | -6.94 | -55.59 | 9.40 | 75.29
Side Longitudinals | 6.00 | -4.48 | -26.88 | 10.00 | 60.00 |  |  |  | Lightweight Summary
Web Frame | 6.17 | -8.30 | -51.21 | 9.50 | 58.62 |  |  |  | Item | Weight (tonne) | LCG from Midship (m) | Moment for LCG (t-m) | VCG from keel (m) | Moment for VCG (t-m)
Ordinary Frame | 3.10 | -8.04 | -24.92 | 9.58 | 29.70 |  |  |  | steelweight | 610.85 | -0.91 | -555.87 | 3.07 | 1876.22
Engine Room foundation | 10.65 | -21.00 | -223.65 | 1.40 | 14.91 |  |  |  | Machinery Weight | 22.00 | -48.01 | -1056.22 | 3.84 | 84.48
Deck Plate | 40.40 | 1.14 | 46.04 | 5.70 | 230.27 |  |  |  | Wood & Oufit | 5.50 | -19.98 | -109.89 | 6.64 | 36.52
Bulwark and stairs | 6.00 | 1.40 | 8.40 | 12.10 | 72.60 |  |  |  |  | 638.35 | -2.70 | -1721.98 | 3.13 | 1997.22
Piping | 12.00 | 0.00 | 0.00 | 5.70 | 68.40
Mast 1 | 3.00 | -28.20 | -84.60 | 24.20 | 72.60
Mast 2 | 1.00 | 36.50 | 36.50 | 9.40 | 9.40
Scrap | 55.00
Funnel | 2.00 | -26.75 | -53.50 | 17.50 | 35.00
 | Total | 610.85 | -61.89 | -506.04 | 115.21 | 1707.27
Total weight calculation
Item | Weight (tonne) | LCG from Midship (m) | Moment for LCG (t-m) | VCG from keel (m) | Moment for VCG (t-m)
Lightship weight | 638.35 | -2.70 | -1723.54 | 3.13 | 1997.27
Fore Peak Tank | 1.00 | 31.80 | 31.80 | 4.50 | 4.50
Aft Peak Tank | 2.00 | -32.99 | -65.98 | 4.40 | 8.80
Tank 1 | 334.00 | 17.01 | 5681.34 | 2.80 | 935.20
Tank 2 | 333.00 | 3.03 | 1008.99 | 2.80 | 932.40
Tank 3 | 333.00 | -10.28 | -3423.24 | 2.80 | 932.40
Tank 4 | 333.00 | 17.01 | 5664.33 | 2.80 | 932.40
Tank 5 | 333.00 | 3.03 | 1008.99 | 2.80 | 932.40
Tank 6 | 333.00 | -10.28 | -3423.24 | 2.80 | 932.40
Fuel Oil Tank | 3.00 | -30.30 | -90.90 | 3.00 | 9.00
Crew Effect | 0.97 | -26.20 | -25.54 | 7.50 | 7.31
 | 2644.32 | 1.76 | 4643.00 | 2.88 | 7624.08

Sheet: Superstructure
Superstructure Calculation
Items | Thicness | Area | Volume | Density(ton/m^3 | Weight(tonne) | LCG | Moment abt Midship | VCG | Moment abt Keel
Poop Deck Plate | 0.006 | 159.17 | 0.95502 | 7.8 | 7.449156 | -26.4 | -196.6577184 | 9.58 | 71.36291448
Forecastle Deck Plate | 0.006 | 66.86 | 0.40116 | 7.8 | 3.129048 | 33.41 | 104.5414937 | 10.69 | 33.44952312
Navigational Deck Plate | 0.006 | 69.7 | 0.4182 | 7.8 | 3.26196 | -20.4 | -66.543984 | 13.75 | 44.85195 | LCG | -17.39071791
Side Plate | 0.006 | 265.2 | 1.5912 | 7.8 | 12.41136 | -24 | -297.87264 | 9.6 | 119.149056 | VCG | 10.23991764
 |  |  |  |  | 26.251524 |  | -456.5328487 |  | 268.8134436
Web Frame
Items | Area | Length | Volume | Density(ton/m^3 | Weight(tonne) | LCG | Moment abt Midship | VCG | Moment abt Keel
WF1 | 0.008 | 3.54 | 0.02832 | 7.8 | 0.220896 | -34.2 | -7.5546432 | 7.4 | 1.6346304
WF2 | 0.008 | 3.54 | 0.02832 | 7.8 | 0.220896 | -32.4 | -7.1570304 | 7.4 | 1.6346304
WF3 | 0.008 | 3.54 | 0.02832 | 7.8 | 0.220896 | -30.6 | -6.7594176 | 7.4 | 1.6346304
WF4 | 0.008 | 4.2 | 0.0336 | 7.8 | 0.26208 | -28.8 | -7.547904 | 8.1 | 2.122848
WF5 | 0.008 | 7.6 | 0.0608 | 7.8 | 0.47424 | -27 | -12.80448 | 9.5 | 4.50528
WF6 | 0.008 | 7.6 | 0.0608 | 7.8 | 0.47424 | -25.2 | -11.950848 | 9.5 | 4.50528
WF7 | 0.008 | 7.6 | 0.0608 | 7.8 | 0.47424 | -23.4 | -11.097216 | 9.5 | 4.50528
WF8 | 0.008 | 11.3 | 0.0904 | 7.8 | 0.70512 | -21.6 | -15.230592 | 11.3 | 7.967856 | LCG | -8.298817106
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
SS8 | 0.01 | 12.87 | 0.1287 | 7.8 | 1.00386 | 32.1 | 32.223906 | 9 | 9.03474
SS9 | 0.01 | 5.5 | 0.055 | 7.8 | 0.429 | 36.2 | 15.5298 | 10.8 | 4.6332
 |  |  |  |  | 8.01528 | -41.42 | -55.6743408 | 97.2 | 75.698064 | 49.51571196

Sheet: W&O
 | Item | No. of Items | Weight (kg) | Total Weight (ton) | LCG (m) | Moment about amidship | VCG (m) | Moment about keel
 | Control Panel | 1 | 500 | 0.5 | -25.1 | -12.55 | 16 | 8
 | Wing Control Panel (Starboard) | 1 | 100 | 0.1 | -25.1 | -2.51 | 16 | 1.6
 | Wing Control Panel (Port side) | 1 | 100 | 0.1 | -25.1 | -2.51 | 16 | 1.6
 | Cabinet | 2 | 35 | 0.035 | -22.8 | -0.798 | 16 | 0.56
 | Chart Table-Chair | 1 | 25 | 0.025 | -22.8 | -0.57 | 16 | 0.4
 | Map Table- Chair | 1 | 25 | 0.025 | -19.8 | -0.495 | 16 | 0.4
 | Radio Instrument Table | 1 | 15 | 0.015 | -19.8 | -0.297 | 16 | 0.24
 | Radio Operator's Chair | 1 | 10 | 0.01 | -19.8 | -0.198 | 16 | 0.16
 | Wash Cabin | 2 | 20 | 0.02 | -22 | -0.44 | 6.8 | 0.136
 |  |  |  | 0 |  |  |  | 0
C.CABIN1 | Single bed | 1 | 70 | 0.07 | -31 | -2.17 | 7.3 | 0.511
 | Locker | 1 | 20 | 0.02 | -31 | -0.62 | 7.3 | 0.146
 | chair | 1 | 10 | 0.01 | -31 | -0.31 | 7.3 | 0.073
C.CABIN2 | Single bed | 1 | 70 | 0.07 | -29.16 | -2.0412 | 7.3 | 0.511
 | Locker | 1 | 20 | 0.02 | -29.16 | -0.5832 | 7.3 | 0.146
 | chair | 1 | 10 | 0.01 | -29.16 | -0.2916 | 7.3 | 0.073
C.CABIN3 | Single bed | 1 | 70 | 0.07 | -26.6 | -1.862 | 7.3 | 0.511
 | Table | 1 | 15 | 0.015 | -26.6 | -0.399 | 7.3 | 0.1095
 | Chair | 1 | 10 | 0.01 | -26.6 | -0.266 | 7.3 | 0.073
 | Wardrobe | 1 | 40 | 0.04 | -26.6 | -1.064 | 7.3 | 0.292
C.CABIN4 | Single bed | 1 | 70 | 0.07 | -27.85 | -1.9495 | 7.3 | 0.511
 | Table | 1 | 15 | 0.015 | -27.85 | -0.41775 | 7.3 | 0.1095
 | Chair | 1 | 10 | 0.01 | -27.85 | -0.2785 | 7.3 | 0.073
 | Wardrobe | 1 | 55 | 0.055 | -27.85 | -1.53175 | 7.3 | 0.4015
 |  |  |  | 0
Owner | Single bed | 1 | 70 | 0.07 | -25.8 | -1.806 | 11.356 | 0.79492
 | Table | 1 | 15 | 0.015 | -25.8 | -0.387 | 11.356 | 0.17034
 | Chair | 1 | 10 | 0.01 | -25.8 | -0.258 | 11.356 | 0.11356
 | Sofa | 2 | 30 | 0.03 | -25.8 | -0.774 | 11.356 | 0.34068
 | Wardrobe | 1 | 40 | 0.04 | -25.8 | -1.032 | 11.356 | 0.45424
 | Wash room items | 3 | 10 | 0.01 | -25.8 | -0.258 | 11.356 | 0.11356
 | TV | 1 | 15 | 0.015 | -25.8 | -0.387 | 11.356 | 0.17034
 | Refrigerator | 1 | 80 | 0.08 | -25.8 | -2.064 | 11.356 | 0.90848
MASTER | Single bed | 1 | 70 | 0.07 | -25.8 | -1.806 | 11.356 | 0.79492
 | Locker | 1 | 20 | 0.02 | -25.8 | -0.516 | 11.356 | 0.22712
 | chair | 1 | 15 | 0.015 | -25.8 | -0.387 | 11.356 | 0.17034
DRIVER | Single bed | 1 | 70 | 0.07 | -24.1 | -1.687 | 6.5 | 0.455
 | Locker | 1 | 20 | 0.02 | -24.1 | -0.482 | 6.5 | 0.13
 | chair | 1 | 15 | 0.015 | -24.1 | -0.3615 | 6.5 | 0.0975
C.CABIN 5 | Single bed | 1 | 70 | 0.07 | -26.4 | -1.848 | 7.3 | 0.511
 | Locker | 1 | 20 | 0.02 | -26.4 | -0.528 | 7.3 | 0.146
 | chair | 1 | 15 | 0.015 | -26.4 | -0.396 | 7.3 | 0.1095
Sr Driver's Room | Single bed | 2 | 120 | 0.12 | -22.579 | -2.70948 | 11.356 | 1.36272
 | Locker | 2 | 40 | 0.04 | -22.579 | -0.90316 | 11.356 | 0.45424
 | chair | 8 | 120 | 0.12 | -22.579 | -2.70948 | 11.356 | 1.36272
 |  |  |  | 0 |  | 0 |  | 0
GALLEY | Single bed | 1 | 70 | 0.07 | -33.97 | -2.3779 | 4.5 | 0.315
 | Cabinet | 1 | 25 | 0.025 | -33.97 | -0.84925 | 4.5 | 0.1125
 | Wardrobe | 1 | 40 | 0.04 | -33.97 | -1.3588 | 4.5 | 0.18
 | Wash room items | 3 | 40 | 0.04 | -33.97 | -1.3588 | 4.5 | 0.18
 |  |  |  |  |  | 0 |  | 0
STORE | Single bed | 1 | 60 | 0.06 | -29.62 | -1.7772 | 4.5 | 0.27
 | Locker | 1 | 25 | 0.025 | -29.62 | -0.7405 | 4.5 | 0.1125
 | chair | 1 | 15 | 0.015 | -29.62 | -0.4443 | 4.5 | 0.0675
 |  |  |  |  |  |  |  | 0
 |  |  |  |  |  |  |  | 0
 |  |  |  |  |  |  |  | 0
Engine Office |  |  | 100 | 0.1 | -24.25 | -2.425 | 2.6 | 0.26
Engine Controll Room | Controll Room Electronics |  | 500 | 0.5 | -24.25 | -12.125 | 2.6 | 1.3
Electric Room |  |  | 350 | 0.35 | -24.25 | -9.1 | 2.6 | 0.91
Miscelleanous |  |  |  | 2
 |  |  | Total | 5.405 |  | -16.28286216 |  | 5.408173913
 |  |  | Total Weight | 4.405 | tonne
 |  |  | LCG(abt amidship) | -19.98 | m
 |  |  | VCG(abt keel) | 6.64 | m

Sheet: Machinery Weight
Items | Quantity | Unit weight (tonne) | Total weight (tonnes) | LCG (m) | Moment (about amidship) | VCG (m) | Moment (about keel)
Main Engine | 1 | 5 | 5 | -24.692 | -123.46 | 1.38 | 6.9
Gear Box | 1 | 4.7 | 4.7 | -25.183 | -118.3601 | 1.4 | 6.58
Generator | 2 | 2 | 4 | -32 | -128 | 1.2 | 4.8
Rudder | 1 | 2.7 | 2.7 | -38.5 | -103.95 | 0.8 | 2.16
steering gear | 1 | 1.2 | 1.2 | -34 | -40.8 | 4.44 | 5.328
Anchor, Chain, winch | 1 | 2 | 2 | 33.56 | 67.12 | 6.89 | 13.78
Propeller, Propeller Shaft | 1 | 2.1 | 2.1 | -35 | -73.5 | 1.019 | 2.1399
 |  |  |  | -155.815 | -520.9501 | 17.129 | 41.6879
 |  | Total Machinery Weight | 21.7 | tonne
 |  | LCG (about amidship) | -48.0138341 | m
 |  | VCG (about Keel) | 3.842202765 | m
