riasatmorshed/name_338_project/(list of files, cad)

Other CAD files:
Rudder/rudder full.dwg
Drawing/Lines Plan.dwg
Engine Room Foundation/engine sectional view.dwg
Propeller/Propeller Profile_new.dwg
Rudder/COUPLING.dwg
Steering Gear/Steering Gear Catalogue.dwg
Drawing/Longitudinal Construction.dwg
Engine Room Foundation/engine top.dwg
Rudder/lower bearing.dwg
Drawing/Shell Expansion.dwg
Drawing/IMO Criteria Check.dwg
Rudder/NACA 0018.dwg
Drawing/GA.dwg
Rudder/Jumping clump.dwg
Drawing/Midship.dwg
Rudder/rudder naca section.dwg
Drawing/Hydrostatic Curve Drawing.dwg
Rudder/upper bearing.dwg
Drawing/Shaft Final.dwg
